nickdnj/stoveiq-open/(commit log)

2026-04-10 Initial commit — StoveIQ Open Source smart cooking monitor
    Fresh repo for open-source pivot. ESP32-S3 + MLX90640 thermal camera
    turned into a local-first smart cooking device. No cloud, no safety
    product baggage, no credentials in history.
    Firmware architecture:
    - 3-task FreeRTOS pipeline: Sensor → Cooking Engine → Web Server
    - WebSocket binary streaming (768 pixels at 4Hz)
    - Connected Component Labeling for per-burner zone detection
    - Smart alerts: boil, smoke point, preheat, forgotten burner
    - BLE WiFi provisioning + AP+STA concurrent mode
    - Desktop emulator with thermal scene scenarios
    Includes: sensor driver, cooking engine, web server with fallback UI,
    WiFi manager, BLE provisio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
    [partitions.csv, stoveiq_enclosure_v1_production.scad]
2026-04-10 StoveIQ Cooking Coach MVP — web app, recipes, calibration, enclosure
    Fix 3 boot crashes, add cooking coach dashboard, 6 thermal recipes,
    burner calibration UI, simulation mode, PVC enclosure design,
    recipe JSON schema, Hackaday page draft, logo and favicon.
    [stoveiq_pvc_enclosure.scad]
2026-04-10 Add PWA install support — service worker, icon endpoint, manifest fix
    - Add /sw.js service worker (cache-first with network fallback,
    skips WebSocket requests, precaches / and manifest.json)
    - Add /icon.png handler serving a 32x32 orange brand-color PNG
    so the manifest has a valid icon URL
    - Fix manifest.json: add id, orientation, categories, dual-purpose
    icons (any + maskable), remove broken icon-192.png reference
    - Register SW in HTML: navigator.serviceWorker.register('/sw.js')
    - Add Cache-Control headers on manifest (24h) and icon (7 days)
    The app is now installable as a PWA on Android Chrome and desktop
    browsers. iOS uses the apple-touch-icon from the inline base64.
    Co-Authored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
    [web_server.c]
2026-04-10 Rotate heatmap 180 degrees — sensor is mounted upside down
    Reverse the temps array after decoding WebSocket binary frame.
    A 180-degree rotation of a row-major 2D image is just reversing
    the 1D pixel array.
    [web_server.c]
2026-04-10 Smooth heatmap interpolation — 8x upscale with bilinear filtering
    Render thermal data to offscreen 32x24 canvas, then drawImage
    scaled to 256x192 with imageSmoothingQuality='high'. Removes
    image-rendering:pixelated. Applies to both main heatmap and
    calibration view. Much better perceived resolution from the
    same 768-pixel sensor data.
2026-04-10 Add runtime temperature calibration — emissivity slider + temp offset
    Sensor calibration:
    - Emissivity now runtime-configurable (0.10-1.00) instead of compile-time
    - Additive temp offset (+/- 20C) for calibrating against a reference
    - sensor_set_emissivity() and sensor_set_temp_offset() API
    Web UI settings panel:
    - Emissivity slider with presets (Ceramic 0.95, Painted 0.85,
    Cast Iron 0.70, Steel 0.30)
    - Temp offset slider (-20 to +20 C)
    - Changes apply immediately via WebSocket
    Lower emissivity = higher reported temps. Use a known reference
    thermometer (IR gun, Thermapen, etc.) and adjust until they match.
2026-04-10 Persist F/C unit preference in localStorage
    Save unit choice to localStorage on toggle, restore on page load.
    Convert settings inputs (boil, smoke, preheat) to F on load if
    user previously selected Fahrenheit. Button text updates on init.
2026-04-10 Add flip display toggle — rotate heatmap 180 degrees from settings
    Checkbox in settings panel to flip the thermal image. Saved to
    localStorage so it persists across reloads. Defaults to on
    (sensor mounted upside down). Uncheck if sensor is right-side up.
    [web_server.c]
2026-04-10 Add mirror left/right toggle for heatmap orientation
    Separate controls for image orientation:
    - Flip Top/Bottom (180° rotation, for upside-down sensor mount)
    - Mirror Left/Right (horizontal flip, for mirror-image correction)
    Both default on and persist to localStorage. Reverses each row
    of 32 pixels independently for the horizontal mirror.
    [web_server.c]
2026-04-10 Sort burners by position instead of heat intensity
    Previously burners were ranked by total heat (hottest = Burner 1),
    causing IDs to shift as temperatures changed. Now sorted by spatial
    position: top-to-bottom then left-to-right in the raw sensor frame.
    This gives consistent burner numbering that matches the physical
    stove layout regardless of which burner is hotter. After the
    flip/mirror transforms in the browser, the mapping is:
    Burner 1: back-left Burner 2: back-right
    Burner 3: front-left Burner 4: front-right
    [cooking_engine.c]
2026-04-11 Add /api/clear-cal endpoint, disable alert beeps during dev
    - GET /api/clear-cal clears burner calibration and switches to
    CCL auto-detection. Fixes stale calibration from pre-flip/mirror
    sessions pointing at wrong positions.
    - Disable beep() during development (early return)
    - Bump max_uri_handlers to 16
    [web_server.c]
2026-04-11 Stop browser from auto-restoring stale calibration on reconnect
    Previously the browser re-sent saved calibration from localStorage
    to the firmware 2 seconds after WebSocket connect. This overrode
    /api/clear-cal and caused burner misdetection when flip/mirror
    settings changed after calibration was saved.
    Now localStorage calibration is loaded for display only. User must
    explicitly re-calibrate from the settings panel to send positions
    to the firmware. This prevents stale calibration from masking
    CCL auto-detection.
    [web_server.c]
2026-04-11 Fix calibration coordinate transform — display to raw sensor space
    Calibration circles are drawn on the displayed (flipped/mirrored)
    heatmap, but the firmware reads from raw sensor coordinates. Added
    inverse transform when sending calibration to firmware:
    flip: raw_r = 23 - display_r, raw_c = 31 - display_c
    mirror: raw_c = 31 - display_c
    Without this, calibration circles pointed at the wrong spot in the
    raw frame, causing burner cards to read ambient temp even though
    the heatmap showed the burner as hot.
    [web_server.c]
2026-04-11 Meal-focused UI — remove heatmap from main view, expand burner cards
    Major UI refactor: the thermal heatmap is now calibration-only.
    The main view shows large burner cards as the primary interface.
    Changes:
    - Remove heatmap, overlay canvas, and info bar from main view
    - Remove flip/mirror code entirely (no more coordinate transforms)
    - Expand burner cards: larger temp display, heat bars, recipe tags,
    temperature-based glow effects, OFF state styling
    - Burner cards show "No burners calibrated" prompt when empty
    - Recipes button moved to header bar
    - Recipe-to-burner tracking (shows recipe name on assigned card)
    - Calibration sends raw sensor coords directly (no transform)
    - Thermal frame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
    [web_server.c]
2026-04-11 Add custom burner names in calibration UI
    - Name input field in calibration overlay
    - Default names: Front Left, Front Right, Back Left, Back Right
    - Names saved in localStorage with calibration circles
    - Burner cards show custom name instead of "Burner N"
    - Calibration circle labels show custom names
    - Name updates when selecting different burner circles
    [web_server.c]
2026-04-11 Disable alert banners during development
    Early return in renderAlerts() — no more slide-in popups for
    boil/smoke/preheat/forgotten alerts. Will re-enable when the
    alert UX is redesigned for the meal-focused view.
    [web_server.c]
2026-04-11 Re-send calibration to firmware on WebSocket connect
    After removing flip/mirror, stale calibration is no longer a risk.
    Browser now sends saved calibration to firmware 1 second after
    WebSocket opens. This ensures calibrated-only mode persists across
    device reboots — only calibrated burners show, no CCL noise zones.
    [web_server.c]
2026-04-21 Phase 1: cookware-based calibration + teaching mode + HTTPS
    - HTTPS via esp_https_server on :443 with self-signed cert (cert/key
    generated via scripts/gen-cert.sh; git-ignored, never committed)
    - HTTP:80 301-redirects to HTTPS; captive portal probes remain on :80
    - mDNS advertises _https._tcp alongside _http._tcp
    - Wake Lock API works over HTTPS (iOS secure-context requirement met)
    Phase 1 UI (all phone-side, zero firmware logic change):
    - Cookware library (CRUD, material presets with default emissivity)
    - Burner View drill-in modal with live canvas temperature graph
    (auto-scale Y, range toggle 1m/5m/10m/all)
    - Event vocab: oil_in, food_in, water_added, rolling_boil, stirred,
    flipped,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
    [web_server.c, wifi_manager.c]
