nickdnj/stoveiq-open/(notices)

Notices in the files:
README.md:
License: MIT
License: CERN-OHL-S-2.0
